74hc595/LPC1114-Synthesizer/(threads)

Thread 1 (2022-05-03):

LED functions

KeenVox, 2022-05-03:
Hi there,

I'm trying to transfer the schematic to a pcb layout. How do I know which LED is the right one for which function. I looked into the code but I don't seem to understand what works with what.

Would appreciate some help. :-D
Thx
Keen
