74hc595/LPC1114-Synthesizer/circuit/lpc1114-synth.pdf

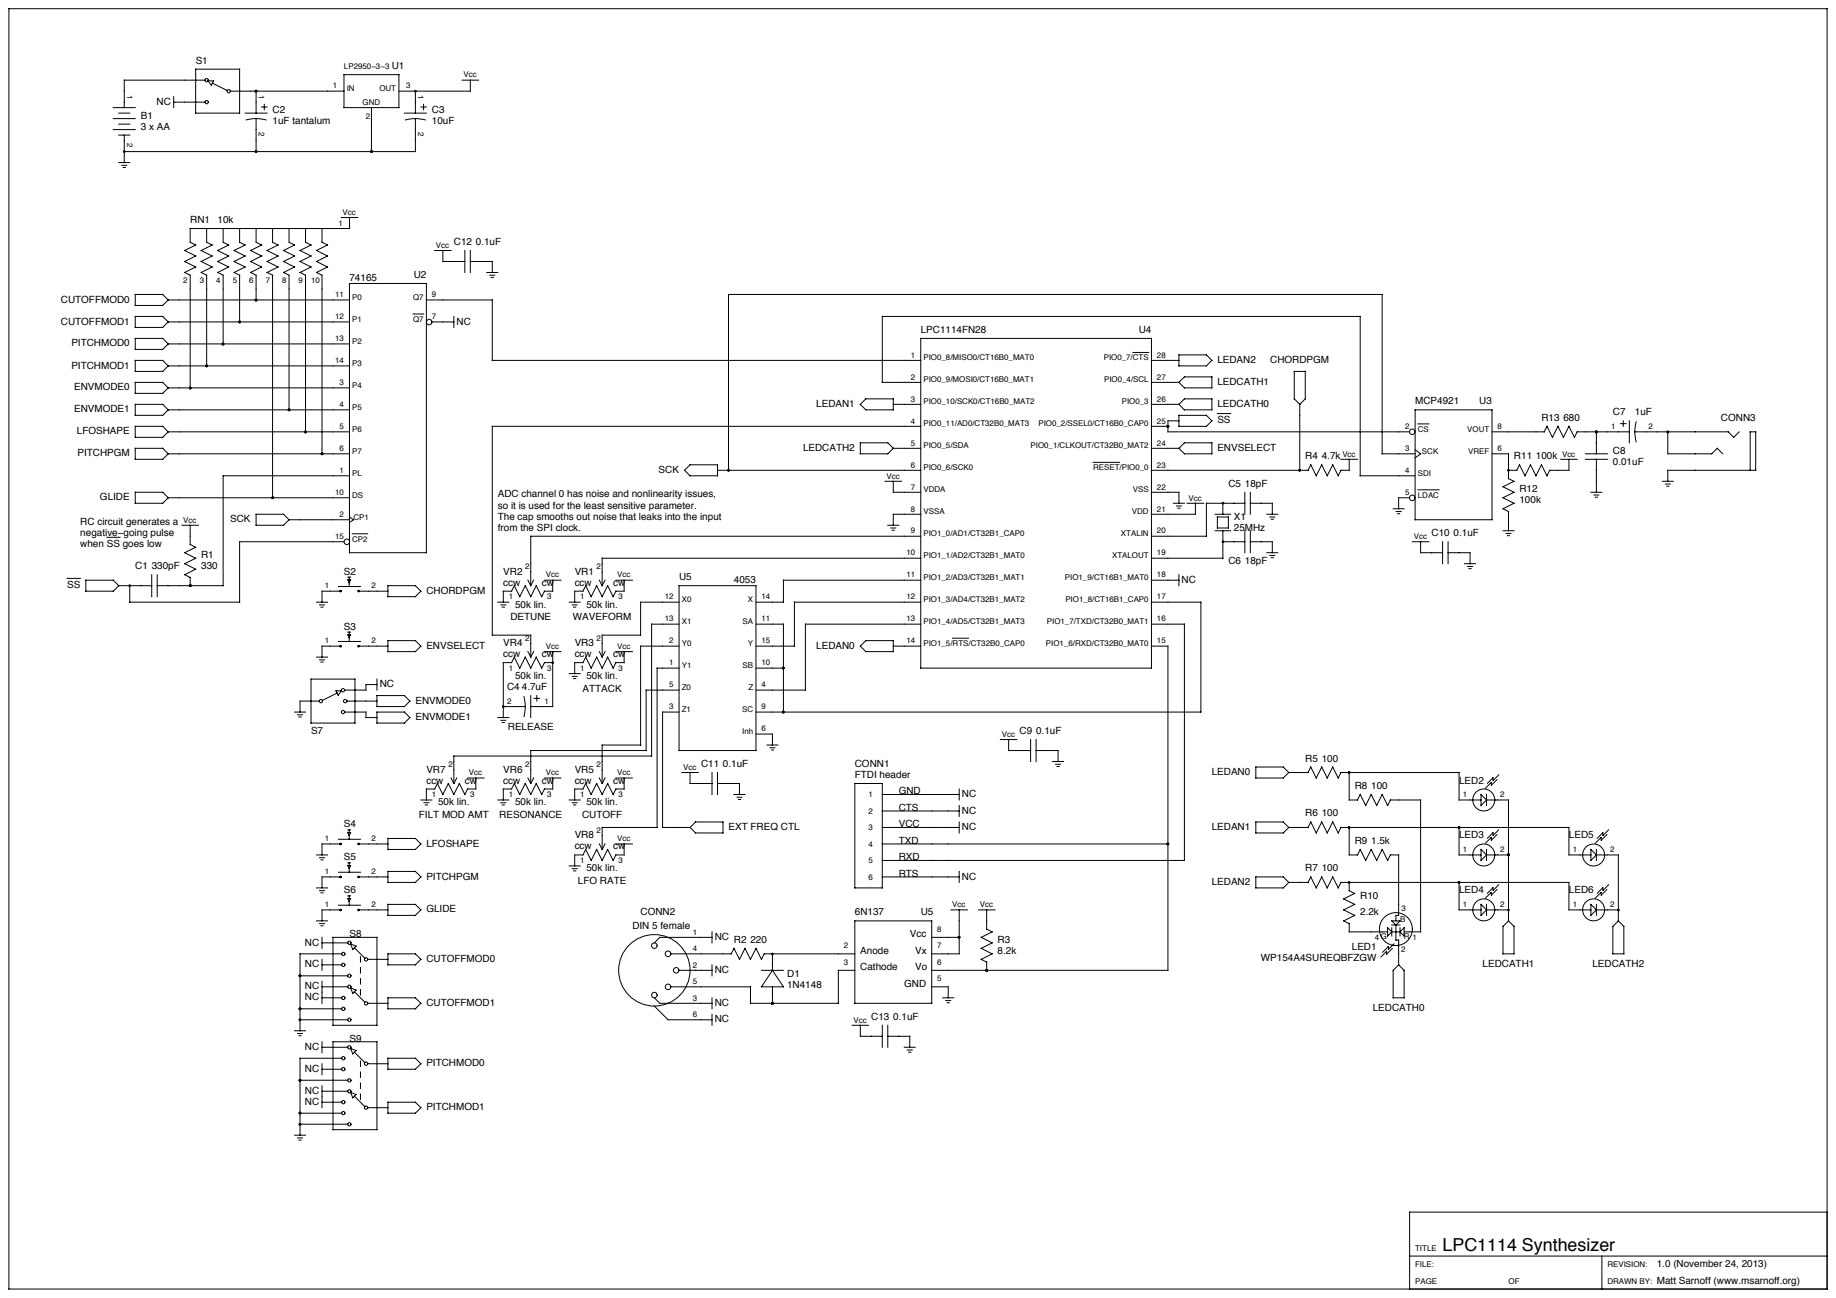
[picture p1: page 1]

ADC channel 0 has noise and nonlinearity issues,
so it is used for the least sensitive parameter.
The cap smooths out noise that leaks into the input
from the SPI clock.

RC circuit generates a
negative−going pulse
when SS goes low

Matt Sarnoff (www.msarnoff.org)
