74hc595/LPC1114-Synthesizer/(commit log)

2013-09-25 outputs 64-sample 1-bit waveform driven by systick
2013-09-26 MCP4811 SPI DAC output
2013-10-02 duty cycle; C API for modifying oscillator params
    [main.c]
2013-10-09 UART and MIDI input
2013-10-11 use a "frequency needs update" flag to reduce frequency updates
    instead of calling it on demand (which is kinda expensive), only do so
    once per tick of the low frequency timer if needed
2013-10-11 pitch bend messages handled
2013-10-16 use SPI mode 3 for DAC
2013-10-17 can read 9 inputs from a shift register while outputting to DAC
    Uses a 74HC165:
    /SSEL -> /CE (pin 15)
    MOSI <- Q7 (pin 9)
    SCK -> CP (pin 2)
    /SSEL -> RC -> /PL (pin 1)
    A ninth input can be connected to DS.
    RC is an RC network that generates a negative-going pulse when /SSEL
    goes low:
    Vcc
    |
    (330 ohm)
    |
    /SSEL ----||----+------ /PL
    330 pF
    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
2013-10-26 added schematic and ADC filtering
    [lpc1114-synth.sch]
2013-10-27 4053 multiplexer; release knob works
    [lpc1114-synth.sch]
2013-10-30 no longer need per-oscillator volume
    pulse wave is still suboptimal and requires 5 cycles per oscillator.
    could potentially be brought down to 3 if we snag another register,
    but that requires 4 cycles, and we'd only save 4 cycles total.
    so, meh
    [main.c, sound.c]
2013-10-30 reassigned knobs to compensate for channel 1's noise and nonlinearity
    [lpc1114-synth.sch]
2013-10-31 attack and release are exponential
    envtable is now an array of time constants used to change the rate of
    exponential rise/decay. the env.py script spits out the appropriate
    values for the user's choice of 256 durations in seconds (i.e. the knob
    gradations.)
    the attack/release knob scale is piecewise; the first "half" (not
    exactly 128 entries because the release knob's ADC channel is
    nonlinear) is a linear scale from instantaneous to 1 second, and the
    second "half" is an exponential scale from 1 second to 10 seconds.
2013-11-01 why didn't i put the constant tables in rom?
    [sound.c]
2013-11-01 filter reenabled
    remaining issues:
    - knob scale needs a lookup table
    - clipping
    - sounds "thinner" when filter applied... like a highpass is happening
    somewhere
    [hardware.c, main.c, sound.c, sound.h]
2013-11-05 use lookup table for filter cutoff frequencies, use 16 bits for F1 and Q
2013-11-12 added filter parameter correction and hard clipping
    [main.c, sound.c, sound.h]
2013-11-12 filter keyboard tracking
2013-11-13 filter cutoff modulated by LFO
    LFO frequency is set via lookup table generated by a script
2013-11-14 buttons and switches are now read via shift register
    [lpc1114-synth.sch]
2013-11-15 modulation source controls work; can't change pitch mod amount yet
2013-11-15 selectable filter mode; lowpass, highpass, bandpass, off
2013-11-15 pitch range and chord program work (again)
2013-11-15 switch debouncing; holding echo button enters serial programming mode
2013-11-16 eliminated "click" when a key is pressed
    this is a big change, and unfortunately a sad one. we can no longer use
    PWM to control the envelope volume, because the DAC output isn't
    bipolar. a signal level of 0 corresponds to a DAC value of 0x800, a dc
    offset of Vref/2. if the attack is instantaneous, playing a note
    immediately causes the DAC output to jump from 0x000 to 0x800, causing
    an audible click. it's not noticeable with a sharp waveform like a pure
    pulse wave, but with a filtered wave it's quite unfortunate.
    the solution is to downscale the output signal by the envelope value in
    the interrupt handler. our total output precision is now 12 bits, which
    is kinda sad.
    on the plus side, we'l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
    [hardware.c, sound.c]
2013-11-20 added LEDs and cathode muxing but they don't indicate anything yet
    [lpc1114-synth.sch]
2013-11-22 fix a hardfault caused by a misaligned array access
    also, the hardfault handler can log the address of the crash
    [main.c]
2013-11-22 leds indicate status
2013-11-23 tweaks to lfo frequency and switch debouncing
2013-11-23 blink glide led to indicate glide strength:
    short = no blinks
    medium = two blinks
    long = three blinks
    [main.c]
2013-11-23 when filter is off, pulse width can be modulated
2013-11-24 finalize version 1.0 of circuit, add BOM
    [lpc1114-synth.sch]
2013-11-25 add PDF schematic
